electronica-digital-2-2025-II/proyecto-g1-e5/src/archivos_importantes/Trashbot_diagrama_de_bloques.pdf

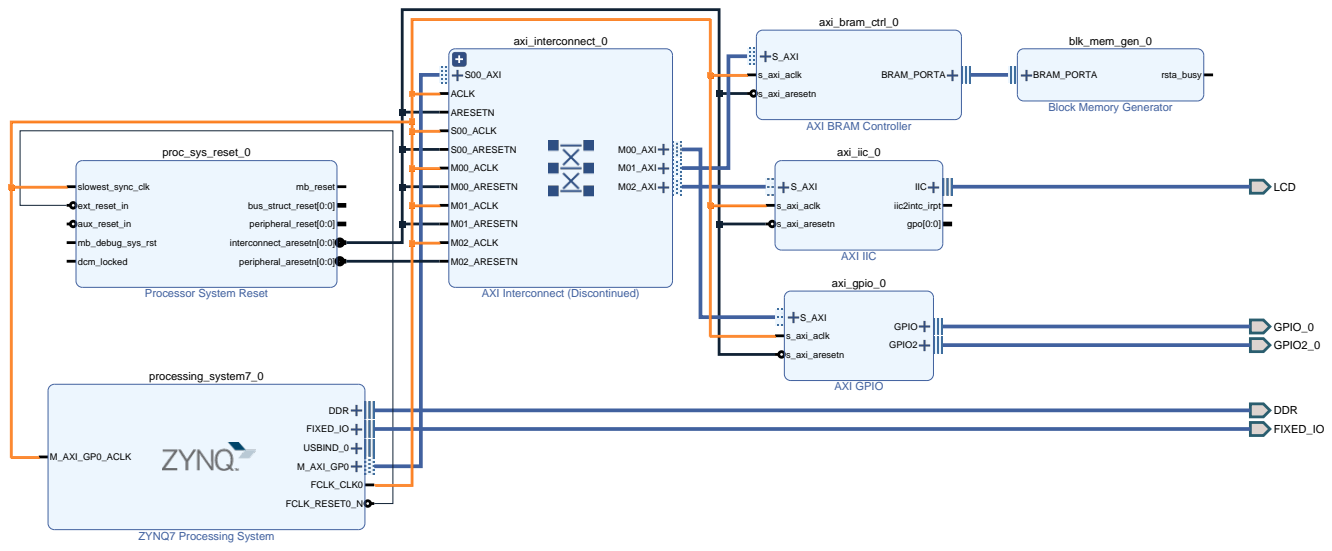
[picture p20: page 1]
DDR FIXED_IO; GPIO_0 GPIO2_0; LCD; axi_bram_ctrl_0; S_AXI; s_axi_aclk; BRAM_PORTA; s_axi_aresetn; axi_gpio_0; AXI GPIO; GPIO; GPIO2; axi_iic_0; AXI IIC; IIC; iic2intc_irpt; gpo[0:0]; axi_interconnect_0; S00_AXI; M00_AXI; M01_AXI; M02_AXI; ACLK; ARESETN; S00_ACLK; S00_ARESETN; M00_ACLK; M00_ARESETN; M01_ACLK; M01_ARESETN; M02_ACLK; M02_ARESETN; blk_mem_gen_0; rsta_busy; proc_sys_reset_0; slowest_sync_clk; ext_reset_in; aux_reset_in; mb_debug_sys_rst; dcm_locked; mb_reset; bus_struct_reset[0:0]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

Block Memory Generator

AXI BRAM Controller

Processor System Reset

AXI Interconnect (Discontinued)
